burakkemalkara/MetuInstrumentProject/Presentation/metu_instruments.pptx

## METU INSTRUMENT

DC/DC CONVERTER
WITH FORWARD TOPOLOGY

## WHY DO WE SELECT FORWARD TOPOLOGY?

ADVANTAGES:
- No air gap in transformer design
- Less current ripple than flyback since filtered output
- Lower current ripple due to larger magnetizing inductance

## WHY DO WE SELECT FORWARD TOPOLOGY?

DISADVANTAGES:
- More components higher cost
- In DCM gain changes too much
- Higher voltage on mosfet and diodes

## TOPOLOGY SELECTİON

- We decide to use Reset winding to increase efficiency
- Select 100kHz,
1. Decrease ripple voltage
2. Increase response of controller

## Transformer Selection

- R material has lower core loss than P material
- E45959 is 2250 W core for 100kHz

## Transformer Design

- Reset windings and Primary windings same, Max D=50%
- Turn ratio is 2 satisfy output gain conditions.
- Minimum turn ratio should be 3 to ensure no Saturation.

## Transformer Design

- Select wire according to max current;
- At min. input voltage,input current is 2A
- Output current is 1A.
- Since system not ideal, efficiency is not 100%,

## Transformer Design

- Core Loss,
- Copper Loss,

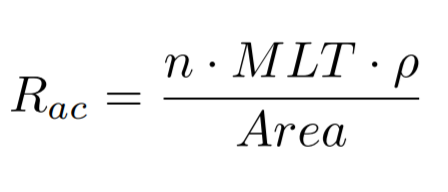
[picture p10: figure]

## Transformer Design

- Window area=550 m^2.
- K_fill=0.3 litz wire.
- Calculations show max N is 70.
- Most efficient N=8.


## Transformer Parameters

## MOSFET Consideration

- Voltage drop is multiple of input voltage, since Reset Winding
- Vds>100V
- Aimed efficiency is 85%, so max input current,

## Mosfet Consideration

IRF 740 N available component at lab.
R_on=0.55 ohm
t_on and t_off is much smaller than Ts

## HeatSink

- TO-220 Package
- ATS-PCB1020
- Rc=6.4

## Component Selection

Output Inductor Consideration
This result is also verified by simulation, but in simulation higher value inductance are needed because of non-idealities.

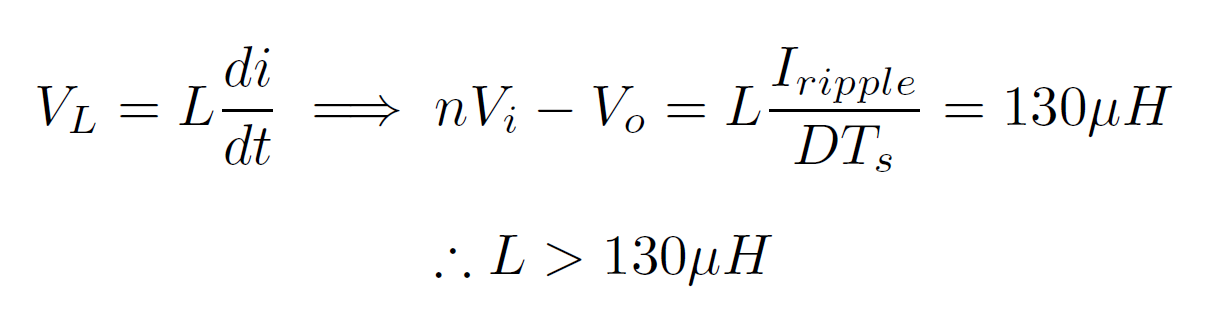
[picture p11: figure]
nesne, saat içeren bir resim Açıklama otomatik olarak oluşturuldu

## Output Inductor Selection

CG3885-ALB 470µH inductor is chosen according to simulation results.
It has 10 A max current and 8 mΩ max DC resistance.

## Output Capacitor Selection

This result is also verified by simulation, but in simulation higher value capacitor are needed because of non-idealities.

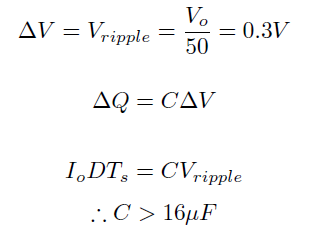
[picture p12: figure]

## Output Capacitor Selection

860080675012 150 µF capacitor is selected.
It has 0.05 Ω ESR value and 50 V DC voltage rating

## Diode Selection

Nearly 100 V has observed on diodes in simulation

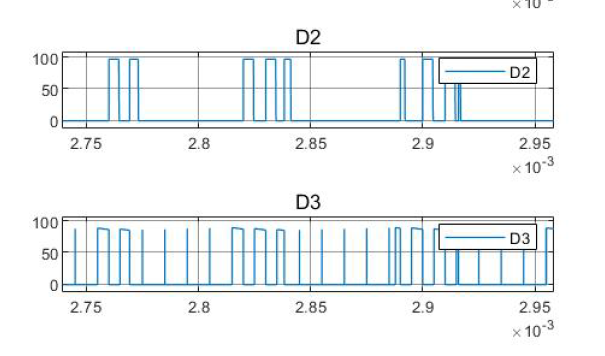
[picture p13: figure]

## Diode Selection

For safety, 200 V 10 A diodes are chosen (DPG10I200PM)
It has 0.98 VF and 0.1 µC recovery charge
35 ns recovery time
-> Vf*If = 0.98V *3.2A = 3.13W conduction loss
QR*VR*fs = 2W switching loss

## Aimed Bonuses

Analog Controller IC: UC3844

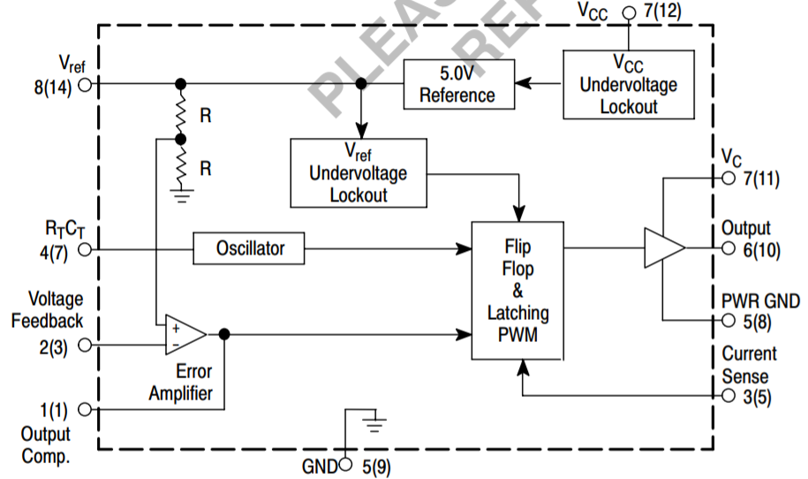
[picture p14: figure]

## UC3844

- Current Mode Controller
- Voltage Feedback
- Soft Start

## Efficiency Bonus

- As simulated at Matlab efficiency is %85.

## Current Mode Control

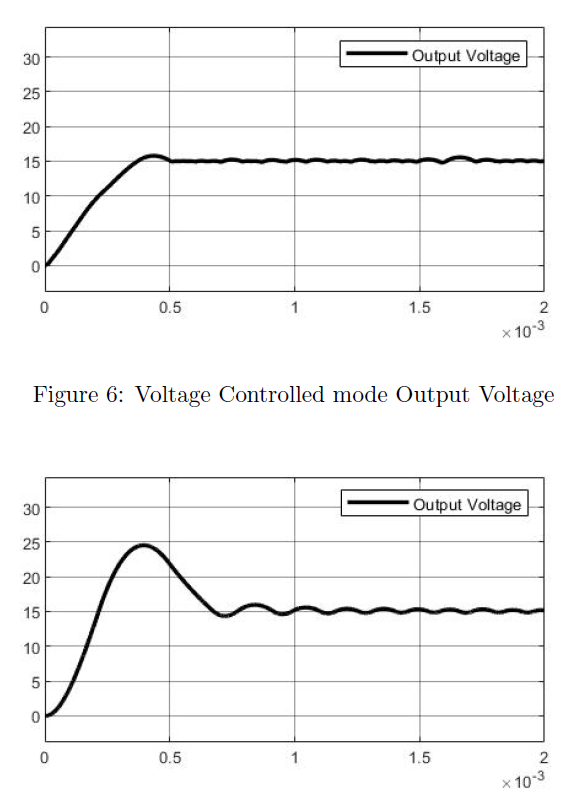
[picture p15: figure]

Current control Mode control decrease
oscillations and output reach steady
state faster.

## Slide 24

- Voltage Control Block

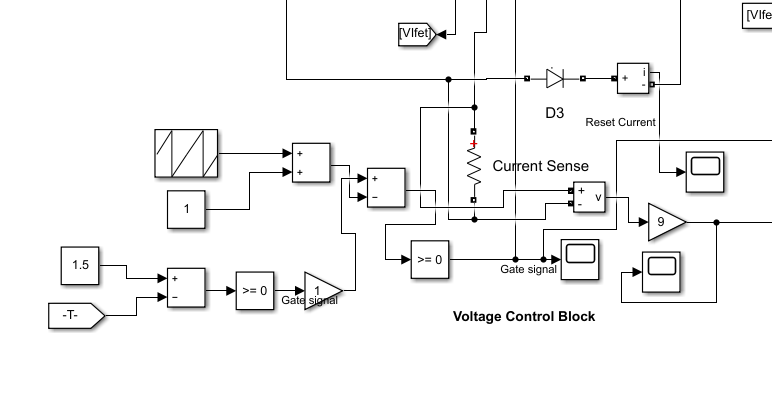
[picture p16: figure]

## Slide 25

- Current Control Block

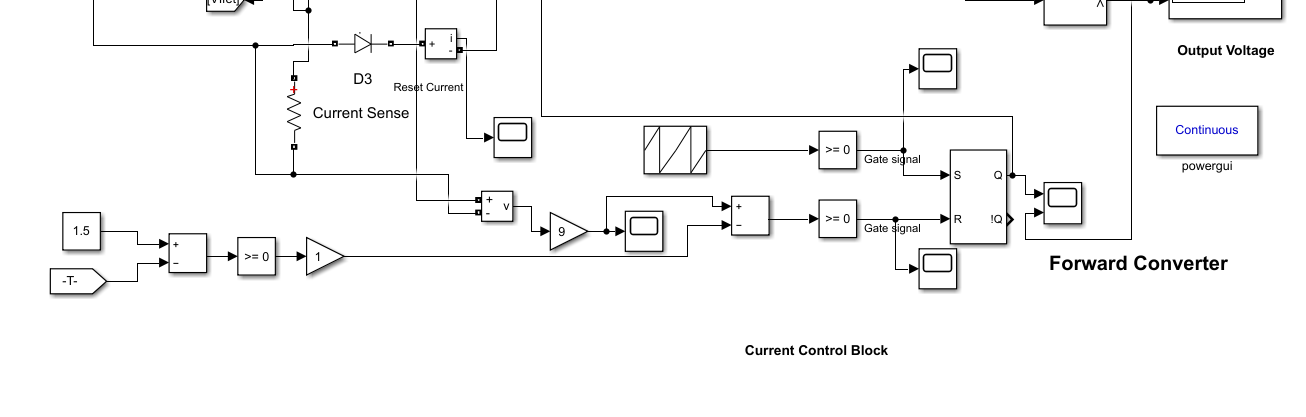
[picture p17: figure]

## PCB

We are planning to implement our nal circuitry on Printed Circuit Board (PCB). Because PCB has some advantages over stripboard. It is more professional than stripboard and it is less noisy. Also, after drawing proper PCB layout it is easy to implement.

## Soft Starting

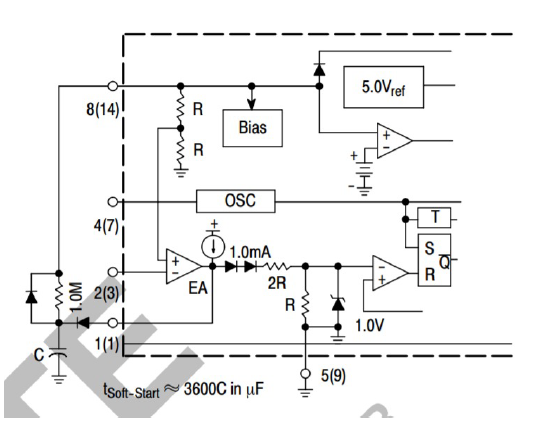
[picture p18: figure]

Soft Starting Ciruit of UC3844

## Isolation

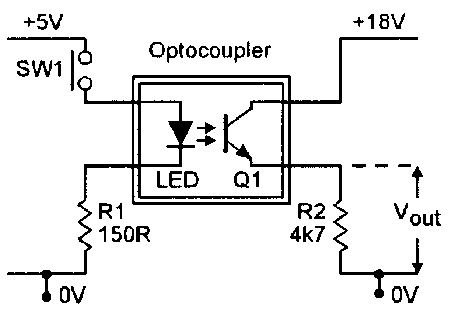
[picture p19: figure]

TLP250 Optocoupler

## Slide 29

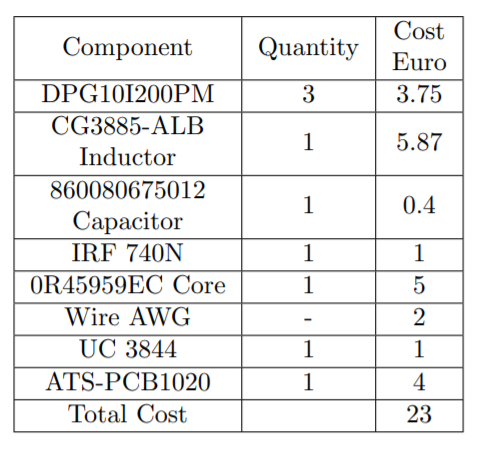
[picture p20: figure]
