burakkemalkara/MetuInstrumentProject/final_report/report.pdf

# DC/DC Voltage Regulator

# Complete Design Report

# Cemil Urg¨up ¨

# Burak Kemal Kara

# A report presented for the sake of Humanity and Science

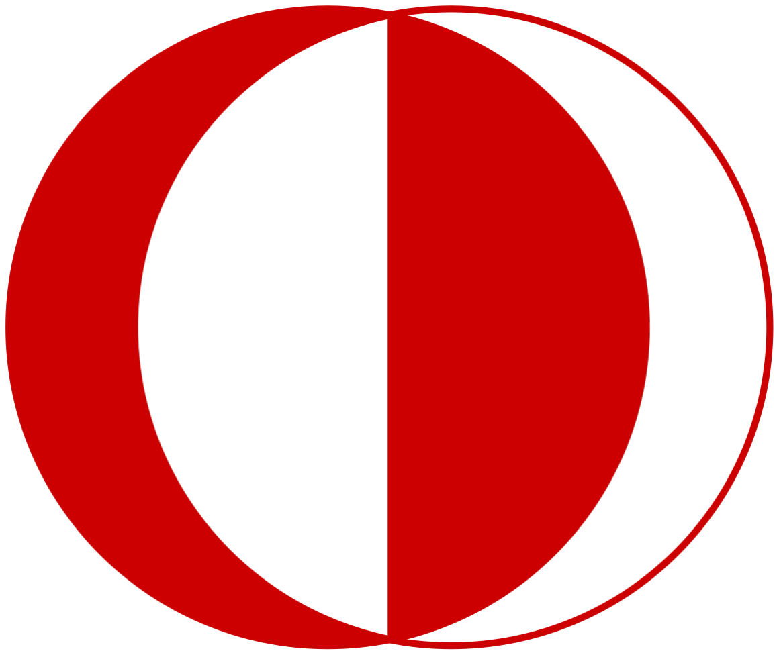
[picture p21: figure]

## Electrical & Electronics Engineering MIDDLE EAST TECHNICAL UNIVERSITY TURKEY

24.05.2020

## Contents

1 Introduction | 2
2 Forward Converter topology | 2
3 Design Equations | 3
4 Input to Output TF | 8
5 Compensator Parameters | 11
6 Current Mode Controller | 13
7 Efficiency and Thermal Analysis | 14
8 Complete simulation in Simulink | 15
9 PCB Design | 15
10 Conclusion | 18

## 1 Introduction

Switch mode power supplies are commonly used to DC/DC converter applications. Beside of voltage control, it provides galvanic isolations. In this project we used Forward Converter topology which is good choice when output need high current and power range is below 200W. In addition, UC3844 IC is examined and simulated in order to obtain constant output voltage with current control. This document aims to discuss component selections,cost and power estimation according to teoric and computational simulation results.

## 2 Forward Converter topology

Forward converter topology is derived from buck converter, at each cycle input transfer power to load side. To avoid saturation at core we choose to use reset windigs.Details are shown Figure 1.


Figure 1: Diagram,schematic and basic waveforms for Forward converter with reset winding cited [5]

In this project, we had different design options as can be seen from Figure 2.


Figure 2: Different Design alternatives of the project

From these alternatives, Forward #1 option is selected. Although, Forward Converter has more components and it is more complex than Flyback Converter, it has some important advantages over Flyback converter such as:

- It has better transformer utilization. It transfers its energy instantly across the transformer and it does not need energy storage element in transformer. For that reason, transformer can be more ideal with higher magnetizing inductance and no air gap

- Output inductor and freewheeling diode ensure continuous output current and it causes less ripple at the output. Furthermore, since main energy storage element is inductor, output capacitor can be smaller than flyback.
- It has less voltage and current stresses on switching components because of larger magnetizing inductance.

Disadvantages of Forward Converter compared to Flyback:

- It is more expensive than flyback because of extra freewheeling diode and output inductor.
- It has minimum load requirements because gain changes a lot in DCM operations

## 3 Design Equations

The following specifications are design equtions for Forward Converter Design.

Minimum Input Voltage (V) | 24
Maximum Input Voltage (V) | 48
Output Voltage (V) | 15
Output Power (W) | 48
Output Volt. Peak-to-Peak Ripple (%) | 2
Switching Frequency (fs) | 100 kHz

Table 1: Design specifications

### 3.1 Transformer Considerations

First of all we should calculate turn ratio of transformer. For the sake of simplicity reset winding and primary winding ratio is same.
n1 = n3 | (1)

This equation limit max duty ratio to 50%, since core cant demagnetize faster than magnetizing time. Primary and secondary winding ratio can found when critical points are considered. When Input decreased minimum, Duty cycle reached max. ratio.At this point this converter should supply desired Vo.

Vo < vi

n3
n1

D =⇒

n3
n1

>

Vo
Vi
- D
= 1.33 =⇒ 2 | (2)

When Vo = 15V as specifications, extra voltage drop on D2 around 1V. Vo,max = 16V .
Minimum voltage is 24 V.
Maximum D is 50%.
At this point we choose R type material ferrite core (Code:0R45959EC). We selected since,R type core loss is less than P type core. According to this core turning factor can found from Lenz Rule,

V = n1

dφ
dt =⇒ Vi,max =

n1 · Bsat · Ae
Dmax · Ts

(3)

∴ n1 > 2.18

Vi,max=48 V
Dmax=0.5
Bsat=0.3
Ae = 368mm²
taken from datasheet [3].

This is minimum turning ratio to avoid core saturation. To calculate max turn number we should calculate wire type to know wire size. At the worst scenario we have Vin,min = 24V . For primary winding,

Iprimary =

Po

Vin,min

= 2A | (4)

For secondary winding,

Isecondary =

Iprimary
n
= 1A | (5)

Since this currents ratings are for ideal case, it is safer to choose higher rating wires.From AWG chart,for primary and reset windings can use AWG #16, Secondary AWG #18. Selection criteria is max current. Their properties are shown at table 2.

AWG | Area mmˆ2 | Max. Current Amperes
AWG#16 | 1.31 | 3.7
AWG#18 | 0.823 | 2.3

Table 2: Wire properties

Core window area is calculated from datasheet.Also geometry parameters are taken from datasheet [3].

Aw = (E − F) · D = 510mm²
(6)

Since area of wires are known max turn can be calculate by,

Nmax =

kf ill · Aw

Apri + n · Asec + Areset

= 71.73 | (7)

Note that fill factor is 0.3 for litz wire.Increasıng turn is good because flux density decreasing and core loss decreasing according to Steinmetz equation, but increased turn also increase resistance of wire and copper loss increased. Core loss equation,

Pf e = Kf e(Bpeak)

βAclm | (8)

Pf e at 100kHz,100mT given 85mW/cm³
Pf e at 100kHz,200mT given 550mW/cm³
By using these values steinmetz parameters calculated as,

∴ β = 2.7 , Kf e = 42

Core loss is simply I

2Rac but wires new resistance should be calcualted by skin effect.Since skin depth decrease wire area new resistance calculated by,

Rac =

n · MLT · ρ
Area | (9)

To find optimum turn number loss calculated at matlab script which provided at github repo.


Figure 3: According to number of turn Total loss calculated

It is better to select turn ratio 8 which Total loss is 1 Watt. At this number Rpri = Rreset = 0.05kΩ, Rsec = 0.06kΩ.
By using AL number windings inductance found and,

Xm = k ·

p
X1 · (X2 + X3) = 1060µH | (10)

Since reset and secondary windings direction same they summed. Also from Steinmetz eqn. Rm can found.Where applied voltage is 48 V.

Pf e = 0.1375W att =⇒ Rm =

V

2
Pf e
= 16.7kΩ | (11)

### 3.2 MOSFET Considerations

Since when switch is off, reset windig decharge core, beside of input voltage additional voltage seen on mosfet.

Vs = Vi +

n1
n2
- Vi = 96V | (12)

For the worst case, selected Vi = 48V . To be stay at the safe side lets make it 150V.

Ii =

Pi
Vi
= 2.22A | (13)

To be safe side minimum current of mosfet should be 5 A. We selected to use IRFB4127PbF [2], its voltage is 200V and Ron = 20mΩ.
According to datasheet turn on and turn off time is totally 120ns.This much smaller than switching toff and toff.

Pcond = I

2
rms · Ron = 0.27W | (14)

Pswitching =

1
2
- Vof f Irms(tr + tf )fs = 1.55W | (15)

Lets use heatsink,Model No. :529802B02500G. Its Rca=3.7C/W. MOSFET Rth is 0.52.Assume enviro-ment temperature is 30C. Thus,

Tj = Cnormal + Ptotal · (RJC + RCS + RJA) = 38.37Celcius. | (16)

### 3.3 Output Inductor Considerations

Since %2 voltage ripple, current change is Iripple = 0.02 ·

Po
Vo

= 0.064AAssume we apply 48 V input, and capacitor is big enough to constat output,

VL = L

di
dt =⇒ nVi − Vo = L

Iripple
DTs
= 130µH | (17)

∴ L > 130µH

We considered ripple voltage limit in our simulations and we chose 470 µH inductor according to our simulations. In addition, previous 10 A current rating selection must be valid for inductor. Therefore, we picked an inductor with 10 A maximum DC current and 470 µH inductance which is “AGP4233-474ME” inductor from Coilcraft. It has also 11.5 m maximum DC resistance and we used that value in our simulations. Since inductors has nonideal series resistance values, there are power losses of these resistance values also. AGP4233-474ME inductor has 11.5 m resistance and it has 3.2 A current. Therefore, power losses on inductor can be calculated as follows:

Pinductor = I

2
- R = 3.2

2

- 11.5 · 10⁻³ = 0.1W | (18)

### 3.4 Capacitor Considerations

When Vin = 48V , D=0.156,

∆V = Vripple =

Vo
50
= 0.3V | (19)
∆Q = C∆V | (20)
IoDTs = CVripple | (21)

∴ C > 16µF

Because of ripple voltage limit, we chose 150 µF capacitor. In addition, we select voltage rating of capacitor as 50 V because of safety limit and possibility of voltage oscillation in case of soft start does not working. Therefore, we picked “860080675012” capacitor from W¨urth Elektronik [4].From datasheet impedance at 100kHz is 0.068Ω.
impedance = ESR +

1
jwC =⇒ ESR = 0.05Ω | (22)

### 3.5 Diode Considerations

As can be seen from Figures 4, there are 100 Volts when diodes are OFF and there are 3.2 A current when they are ON. Therefore, because of safety margin and high current possibility at the starting we chose 200 V and 10 A ratings for diodes. Hence, we picked “DPG10I200PM” [1] fast recovery diodes. For diodes another important parameter is reverse recovery time and this diode has 35 ns which is enough for 100 kHz frequency applications.


Figure 4: Diodes

Output diodes has 0.98 V voltage drop and at steady state their current will be 3,2 A. When one diode is ON the other diode is OFF at the output. Therefore, we can calculate conduction losses by simply multiply voltage drop and forward current.

Pconduction = Vf If = 0.98V · 32A = 3.13W | (23)

For calculating switching losses of diodes, reverse recovery charge, blocking voltage and switching frequency is needed. From Figure 5, we can estimate our reverse recovery charge as 0.1 µC. Blocking voltage is 100 V from simulations and switching frequency is 100 kHz.


Figure 5: Reverse recovery charge values of DPG10I200PM

From these values, switching losses of two diodes can be calculated as follows:

Pswitching = QRVRfs = 2 · 0.1 · 10⁻6 · 100V · 100kHz = 2W | (24)

We used same heatsink that we use at mosfet

Tj = Cnormal + Ptotal · (RJC + RCS + RJA) = 73Celcius. | (25)

## 4 Input to Output TF

To derive TF, first I will find small signal circuit equivalent. Forward converter can be treated as a buck converter with Vin = n · Vin where n is transformer ratio.

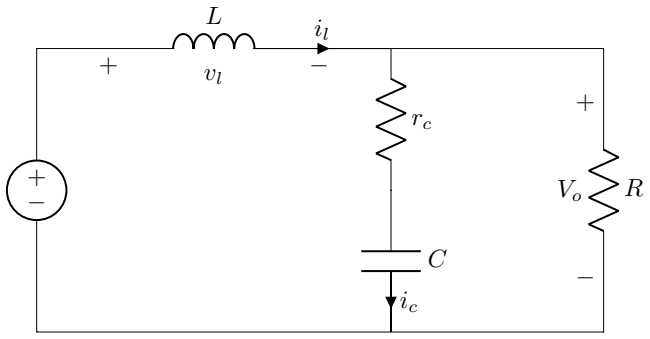
[picture p22: figure]

Figure 6: Simplified Forward Converter when switch is on

KVL at the outer path,

−nVin + L

di
dt + ioR = 0 | (26)

Since,
io = il − ic | (27)

L

di
dt = nVin − Ril + Ric | (28)

Find ic by KVL on inductor and capacitor

−nVin + L

di
dt + icrc + Vc = 0 | (29)

ic =

nVin − L

di
dt − Vc
rc

(30)

Insert ic into equation 3, ˆil =

di
dt =

nVin
L

−

rcR
(rc + R)L

R
(rc + R)L
Vc | (31)

We know that R >> rc so we can simplify equation as,

ˆil =

nVin
L

−

rc
L

il −

1
L
vc | (32)

Start derive Vc by KCL at output node,

ic = il −

Vo
R

(33)

Since,
vo = vc + rcic | (34)

ic =

R
R + rc

il −

1
R + rc
vl | (35)

Since,

vˆc =

ic
C

(36)

vˆc =

R
C(R + rc)

il −

1
C(R + rc)
vl | (37)

We know that R >> rc so we can simplify equation as,

Vˆ
c =

1
C

il −

1
RC vl | (38)

According to state space equations,

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
Vin | (39)

For switch off position A matrix hasn’t changed.But B matrix multiplied with duty ratio so,

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
Vin | (40)

Find vo as state space variables,
vo = vc + rcic | (41)

Since,
ic = il −

v − o
R

(42)

vo = vc + rcil −

vorc
R

(43)

vo =

rcR
rc + R

il +

R
(rc + R)
vc | (44)

Since rc << 1,
vo = rcil + vc | (45)

C =

rc
1
(46)

vo(s)
d(s)

= C

T
[SI − A]
−1BVin | (47)

After a lengthy evaluation control to output TF is,

Gvd =

veo
de
vei=0

=

nVin

LC "
srcC + 1
s

2 + s(

rc
L +

1

RC ) + 1

LC #
(48)

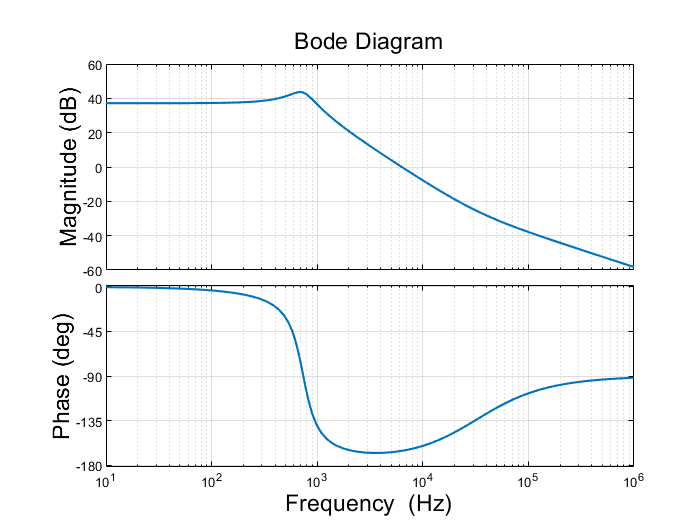
[picture p23: figure]

Figure 7: Bode plot of control to output TF

According to [erickson] Crossover Frequency is defined as the frequency where the magnitude of loop gain is unity.Limit for fc is pole frequency since we want to operate unity gain at fc.For power application switching frequency selected as one in ten or five.For this application I select as,

fc =

fsw
5
= 20kHz | (49)

Since fESR = 32kHz and fLC = f734Hz,

fLC < fc < fESR < fsw/2 | (50)

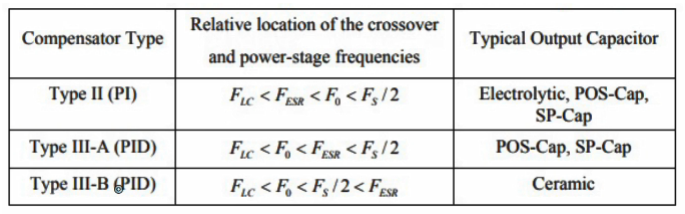
[picture p24: figure]

Figure 8: Compensator Selection table

According to table 8 I select Type 3-A compensator for this application.Type 3 compensator supplies phase boost for this converter to operate stable region.

## 5 Compensator Parameters

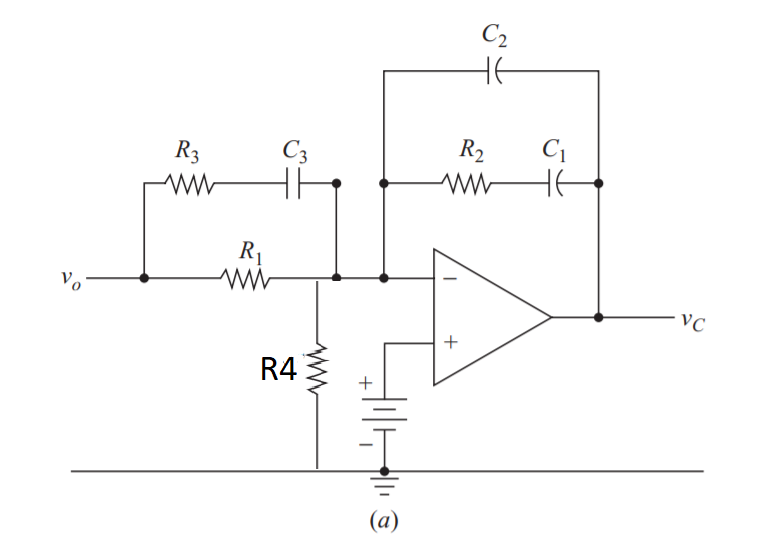
[picture p25: figure]

Figure 9: Type 3 Compensator

This compensator is referred from [erickson] book except one extension.R4 added to adjust input voltage range. When fc = 20kHz, from bode plot phase angle is -146 and gain is -20 db. Vref = 3V , which corresponds -9.5db.
|G(jwo)| = 29.5dB = 29.5Gain | (51)
θcomp = θphase−margin − θconverter = 45 − (−146) = 191 | (52)

K = tan191 + 90
2

2
= 7.75 | (53)

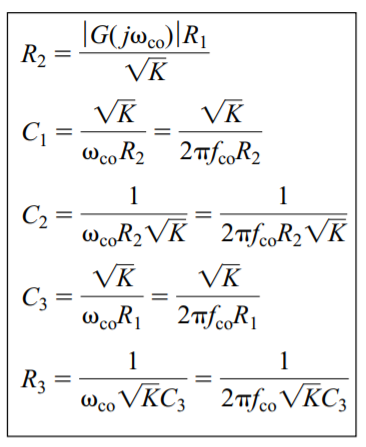
[picture p26: figure]

Figure 10: Type 3 Compensator equations

To start lets choose R1 = 1kΩ, Afterwards by using formulas at figure 5, other parameters found as,

R2 = 10.77kΩ , | C1 = 2nF , | C2 = 0.26nF , | C3 = 22nF , | R3 = 130Ω | (54)

It is suitable to measure output voltage with vo
3
| | ,

vref =

| vo
| 3 R4 R4 + R1 | =⇒ R4 =

vrefR1

| | vo
3 − vref
| | | = 1.5kΩ | | (55)

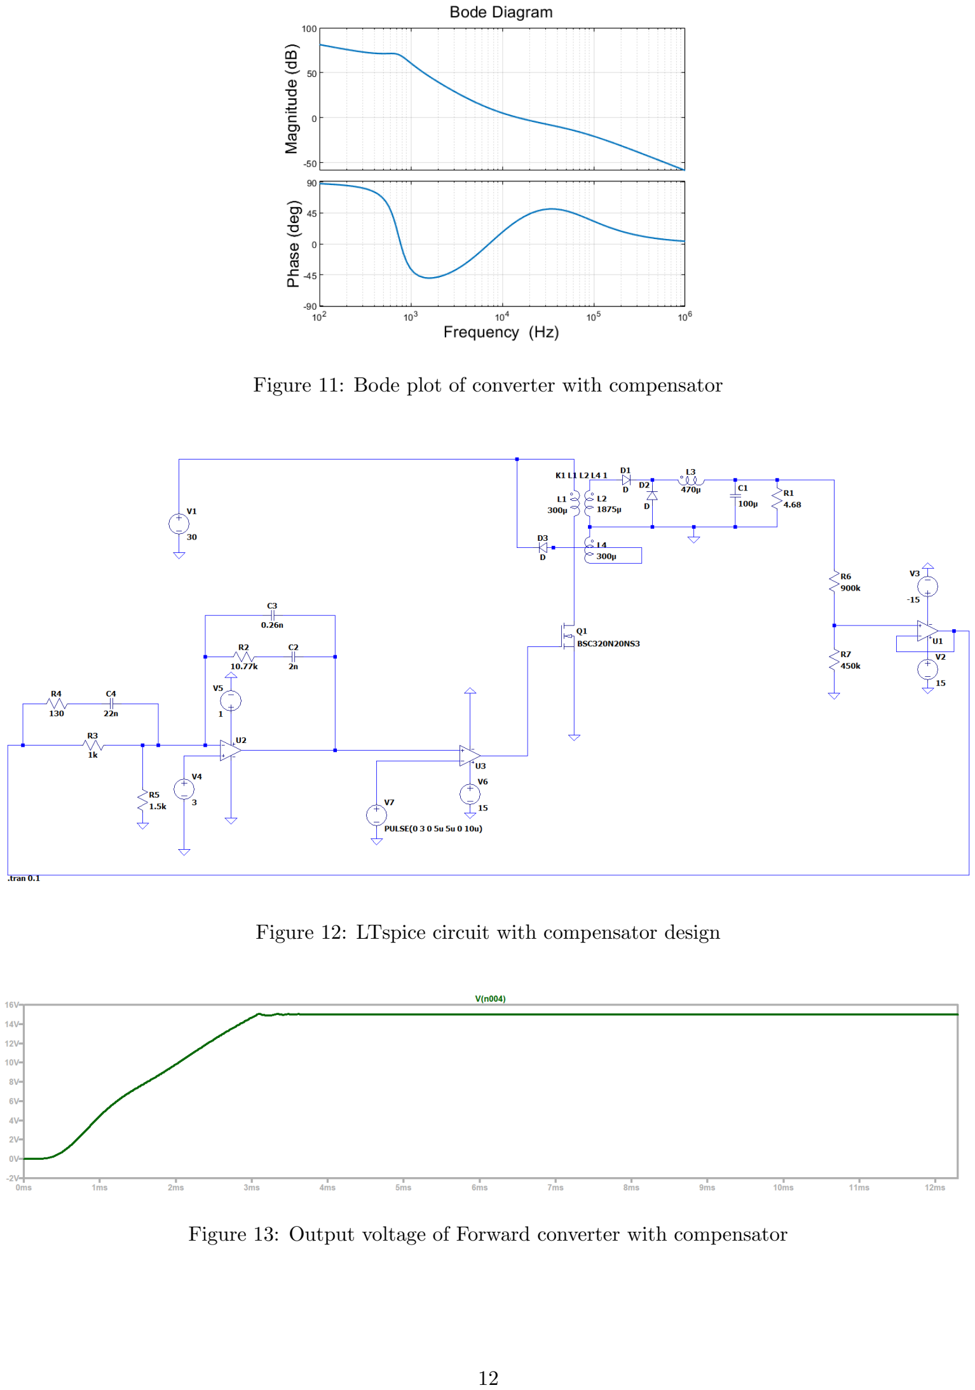
[picture p27: page 13]

Figure 11: Bode plot of converter with compensator

Figure 12: LTspice circuit with compensator design

Figure 13: Output voltage of Forward converter with compensator

## 6 Current Mode Controller

We select LT3758 current mode controller for this application.According to datasheet output voltage formula determined by feedback loop,

Vo = 1.6 ·

1 +

R2
R1
(56)

To have 15V resistor selected as,
R1 = 10kΩ , | R2 = 83.75kΩ | (57)

Sense pin is directly fed from to source of mosfet.Rsense used at the source of mosfet.According to datasheet

Rsense =

80mV

Il−peak

= 0.01Ω | (58)

Since operating frequency is 100kHz, according to datasheet 140kΩ fasten to RT pin. Also error amplifier used in this controller. At the datasheet they suggest to use typical application parametes at the datasheet.

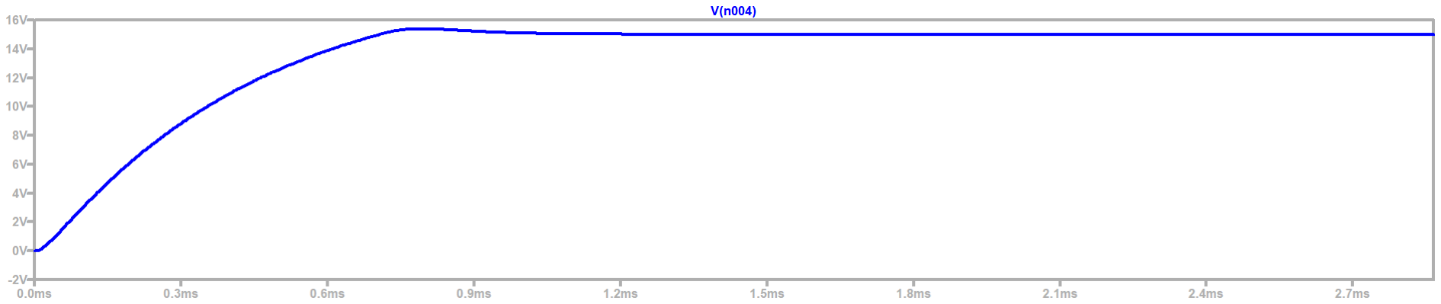
[picture p28: figure]

Figure 14: Output Voltage with current mode controller

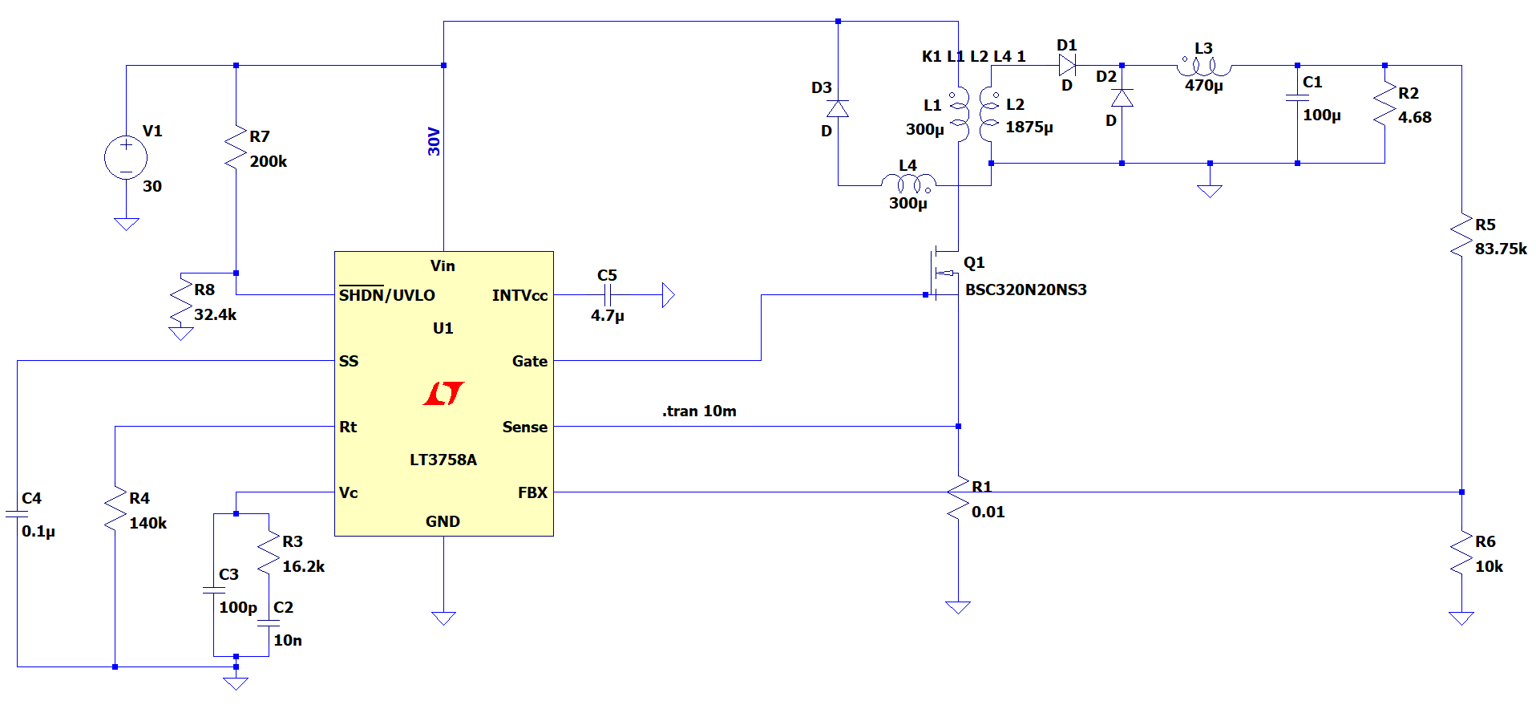
[picture p29: figure]

Figure 15: Circuit with current mode controller

Current mode controller is advantageous when compare with voltage control compensator. It is important that settling time of current mode controller is 5 times better than voltage control.Also steady state ripple decreases.

## 7 Efficiency and Thermal Analysis

### 7.1 Thermal Circuit Simulation

Thermal analysis checked by calculations before. In this section we will prove that simulation tools also gives close result with calculations.

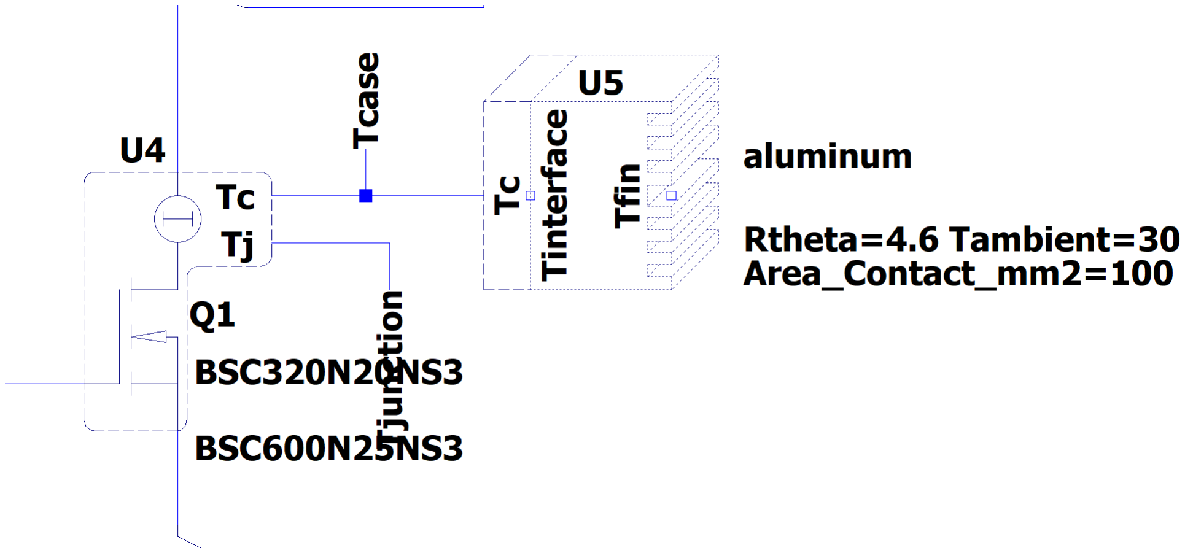
[picture p30: figure]

Figure 16: Thermal analysis simulation design

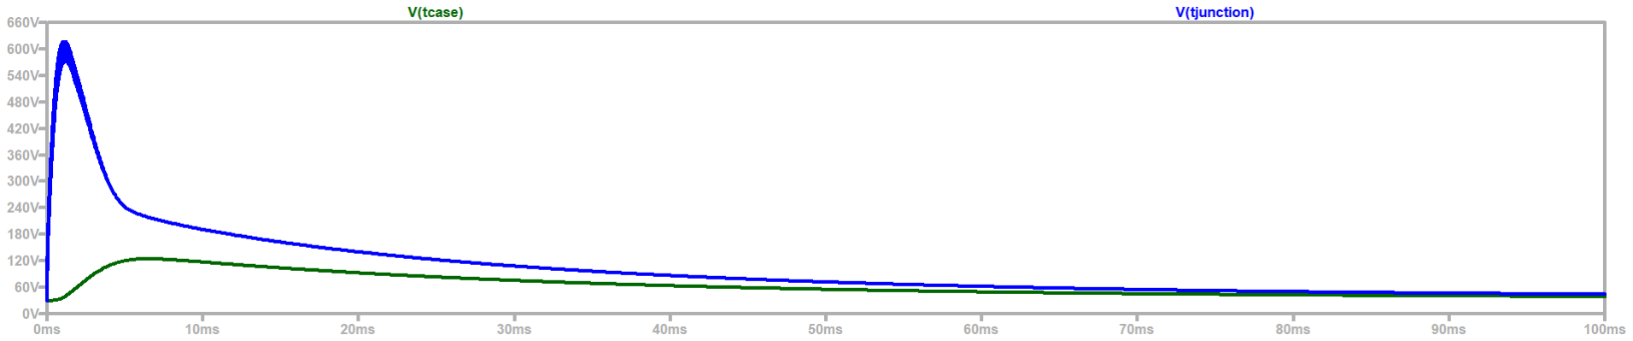
[picture p31: figure]

Figure 17: Junction and case temperatures when voltage compensator used

Figure 12 shows that FET temperature is saturated at 40 Celcius if ambient is 30 celcius.It is expected since we calculated analytically 38 Celcius.

### 7.2 Efficiency Simulation

As calculated analytically at design equations,

Ptotal,loss = Ptransformer + Pmosf et + 2 · Pdiode + Pinductor = 13.1W | (59)

eff =

Pout

Pout + Ploss

=

48W
48W + 13.1W
= %78 | (60)

We construct a forward converter at simulink environment with current mode controller.Efficiency of circuit with all nonidealities calculated at that simulink program. You can find it in github repository under simulation results.According to that simulation efficiency calculated as %73. This is close to our analytical result.

## 8 Complete simulation in Simulink

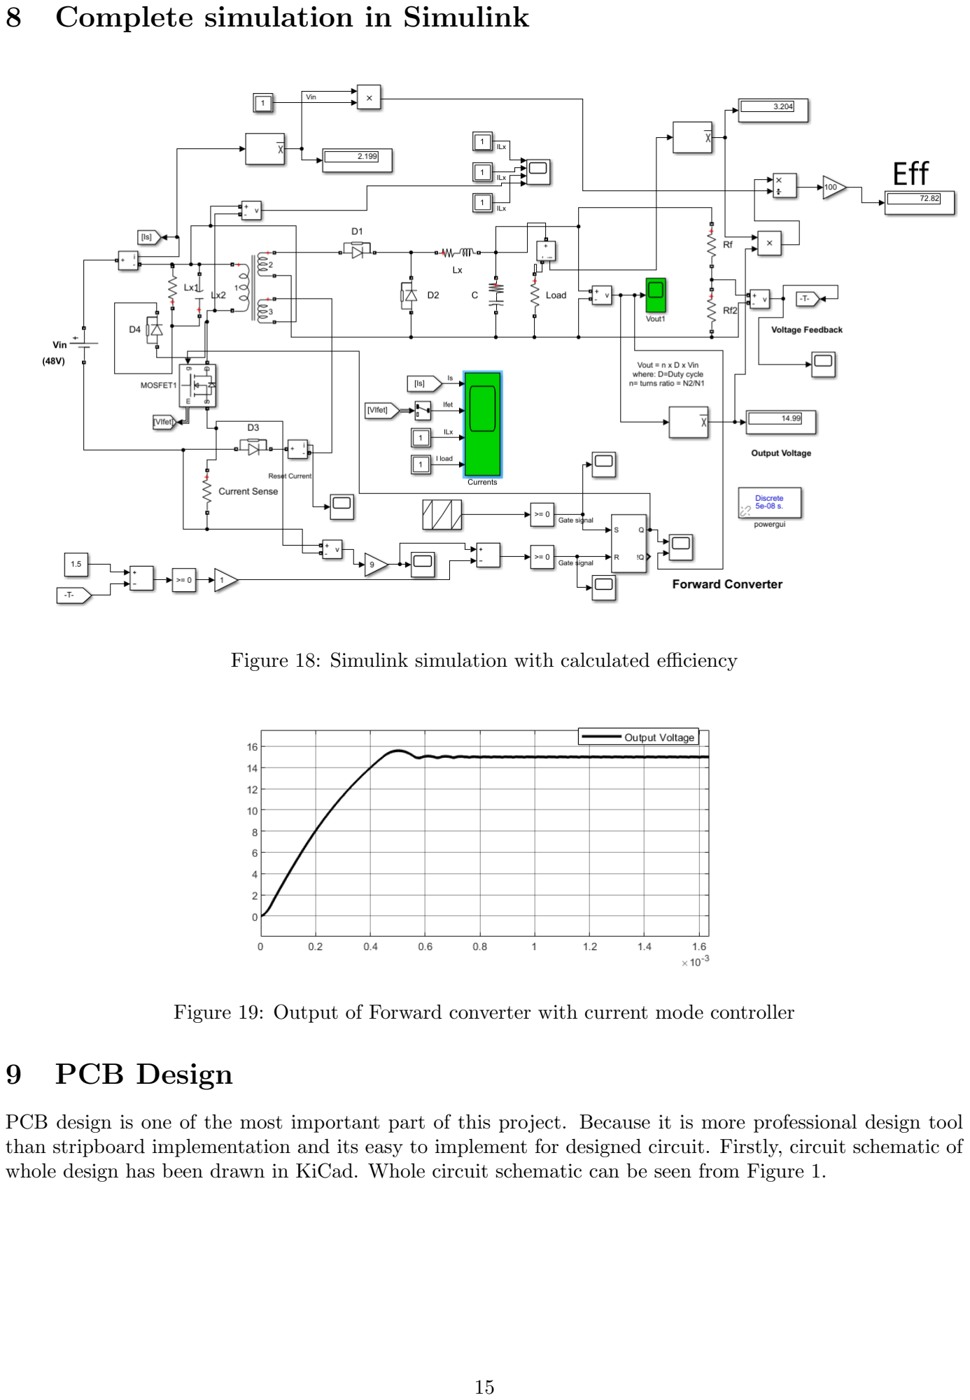
[picture p32: page 16]

Figure 18: Simulink simulation with calculated efficiency

Figure 19: Output of Forward converter with current mode controller

## 9 PCB Design

PCB design is one of the most important part of this project. Because it is more professional design tool than stripboard implementation and its easy to implement for designed circuit. Firstly, circuit schematic of whole design has been drawn in KiCad. Whole circuit schematic can be seen from Figure 1.

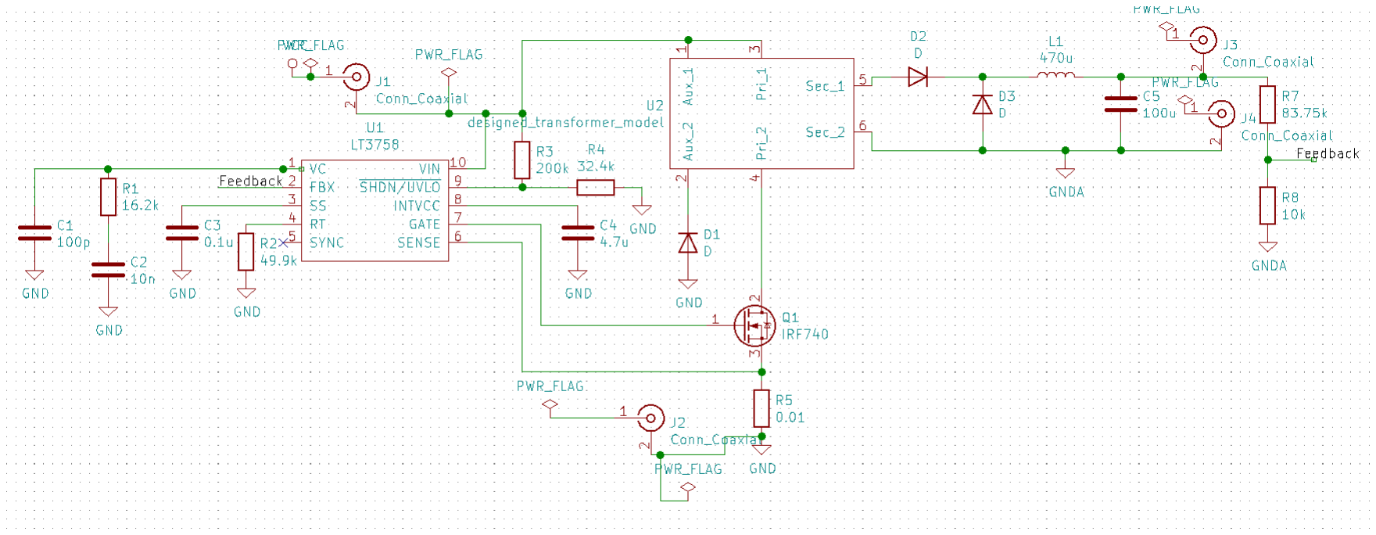
[picture p33: figure]

Figure 20: Circuit Schematic of Designed Circuit

In this schematic, controller, passive components, diodes, transistors and designed transformer is shown. Symbol of designed transformer is created by us because there is no proper symbol for a transformer with two main and one auxiliary winding. Transformer symbol has four input and two output. After completing circuit schematic, next task is arranging proper footprints to all components. Most of the components has their own footprints on KiCad, but some of them has no footprints of their own. Therefore, proper footprints have been drawn in KiCad, according to their packages. For example, footprints of transformer and output inductor has been drawn by us and matched their own schematic symbols. Then, next task is creating PCB layout. Connections between components were completed according to their footprints. Created PCB layout can be seen from Figure 2.

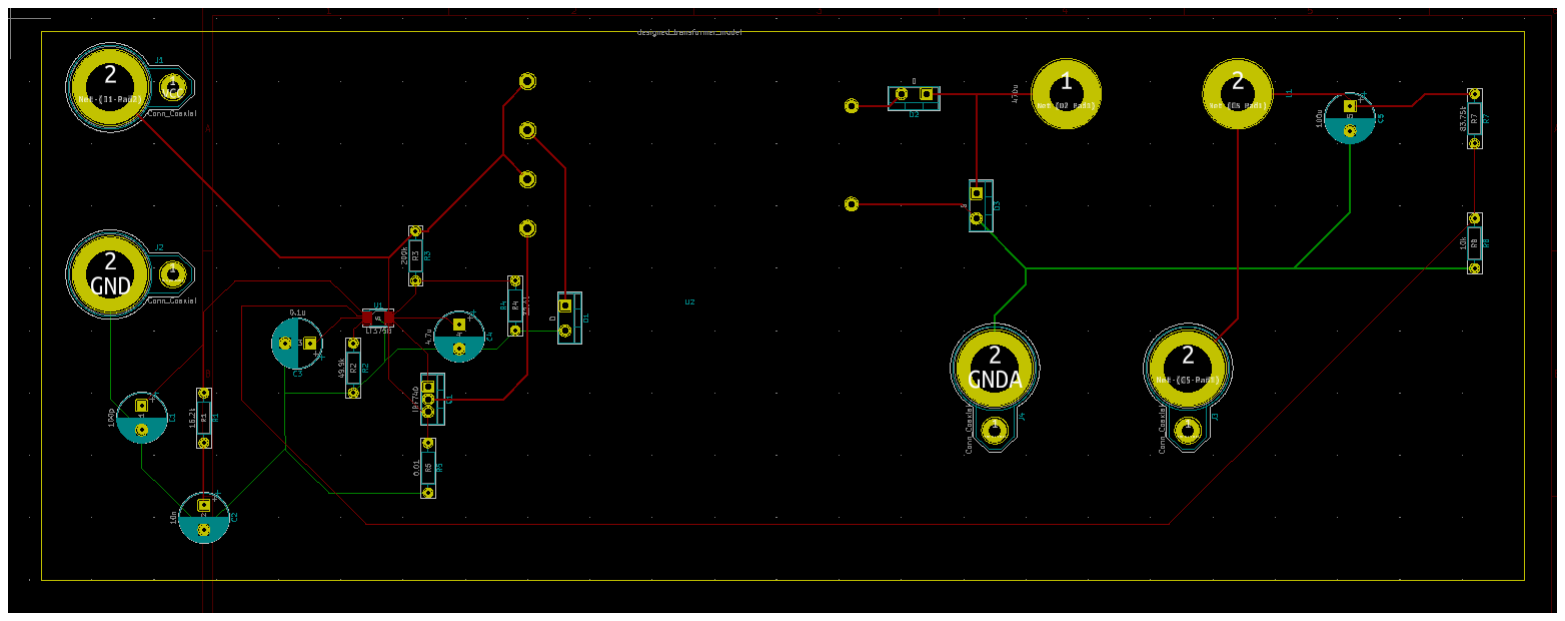
[picture p34: figure]

Figure 21: PCB Layout of the Circuit Schematic (without ground pads)

Widths of connections has been arranged according to current and power ratings of the components. There are use conventions for copper thicknesses and widths. We used below conventions to arrange widths of traces.

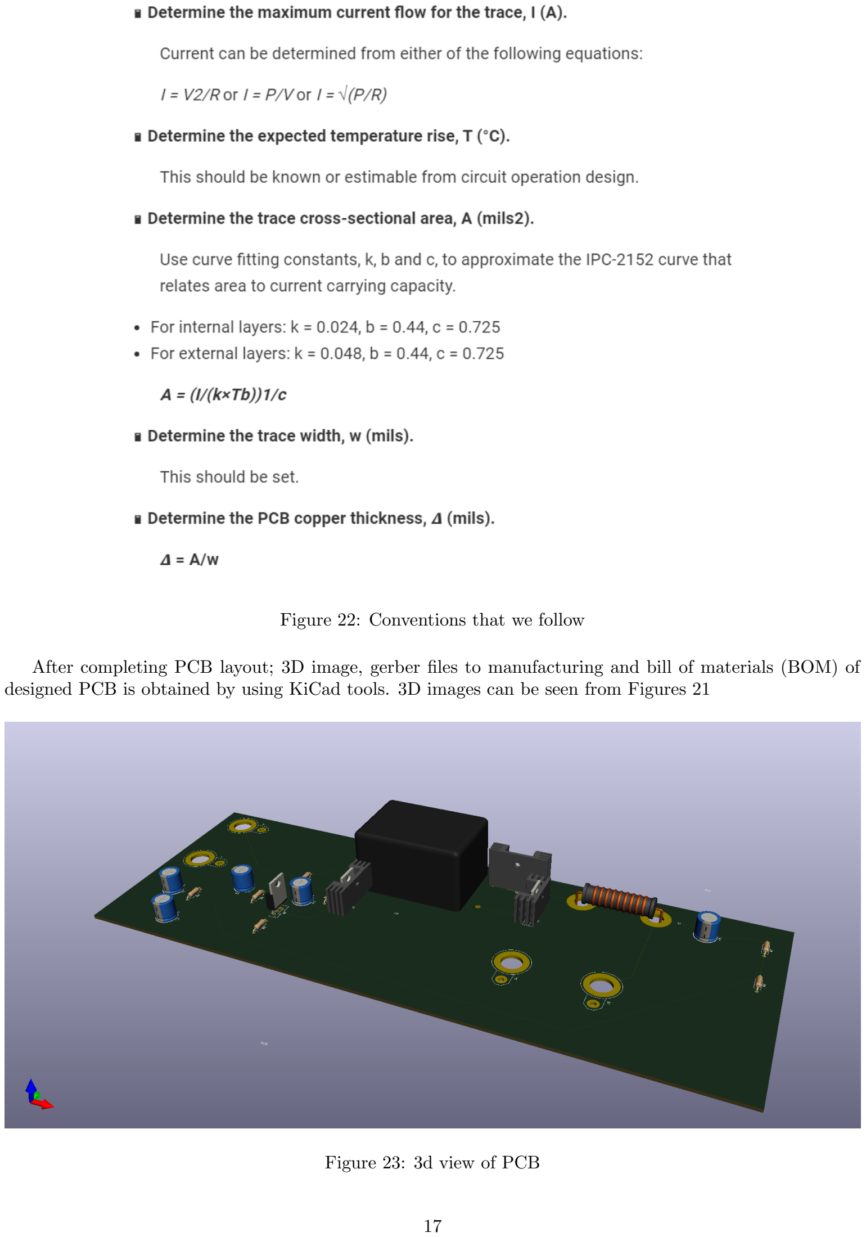
[picture p35: page 18]

Figure 22: Conventions that we follow

After completing PCB layout; 3D image, gerber files to manufacturing and bill of materials (BOM) of designed PCB is obtained by using KiCad tools. 3D images can be seen from Figures 21

Figure 23: 3d view of PCB

You can find BOM file at the github repository. We also order 1000 piceses of pcbs from pcbway.

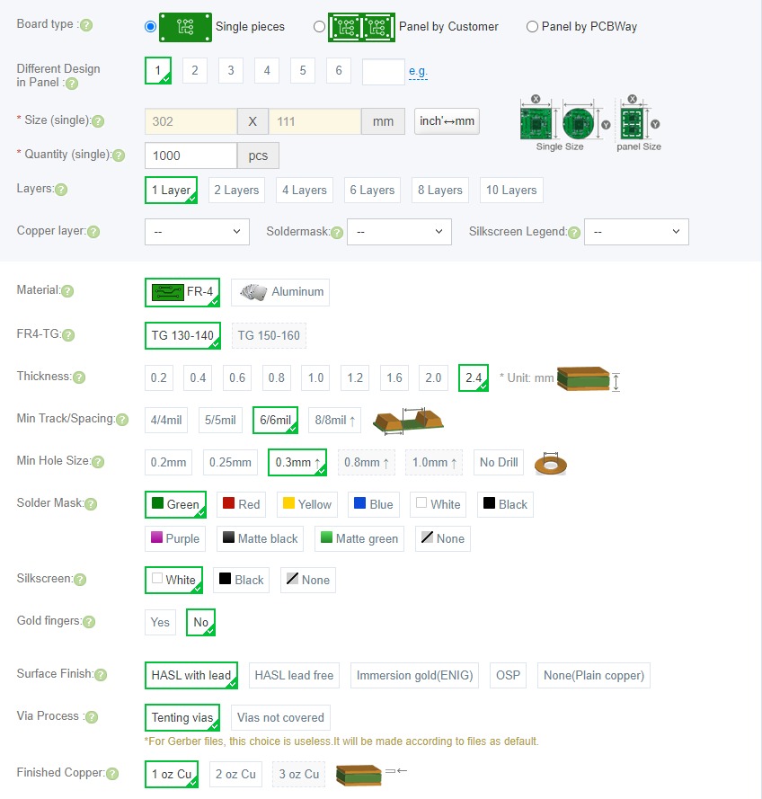
[picture p36: figure]

Figure 24: Ordered pcb properties

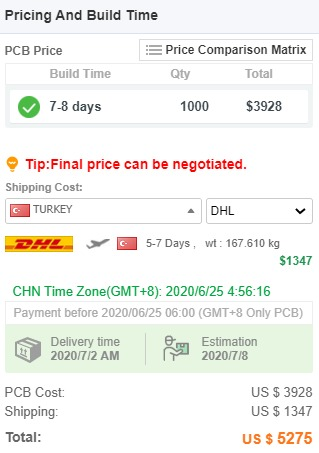
[picture p37: figure]

Figure 25: PcbWay bill

## 10 Conclusion

Forward converter designed with simulations, calcualtions and pcb designs. Observed how non-ideal char-acteristic affect converter. Investigate different control strategies on converter. Current mode control is advantageous on voltage control. We also analyzed that circuit temperature according to heatsink.

## References

[1] DPG diode. https://ixapps.ixys.com/Datasheet/DPG10I200PM.pdf.

[2] irfb4127pbf POWER MOSFET. (https://www.infineon.com/dgdl/irfb4127pbf.pdf?fileId=5546d462533600a401535615c2ef1e11) https://pdf.direnc.net/upload/irf740a-datasheet.pdf.
[3] 0R45959EC R Material Core. https://www.mag-inc.com/Media/Magnetics/Datasheets/0R45959EC. pdf. (https://www.mag-inc.com/Media/Magnetics/Datasheets/0R45959EC.pdf)
[4] Capacitor. https://www.mouser.com.tr/datasheet/2/445/860080675012-1726029.pdf.
[5] Forward Converter Topology. https://www.mouser.com/pdfdocs/2-10.pdf.
