burakkemalkara/MetuInstrumentProject/CC.PNG

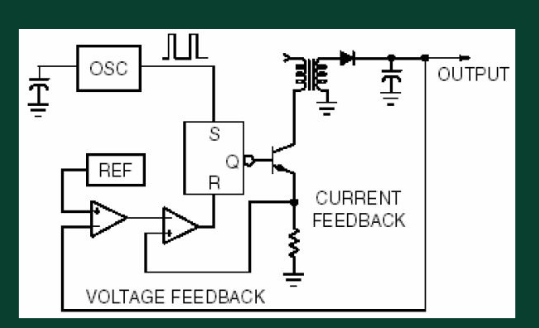
CC.PNG
