burakkemalkara/MetuInstrumentProject/final_report/bode_com.png

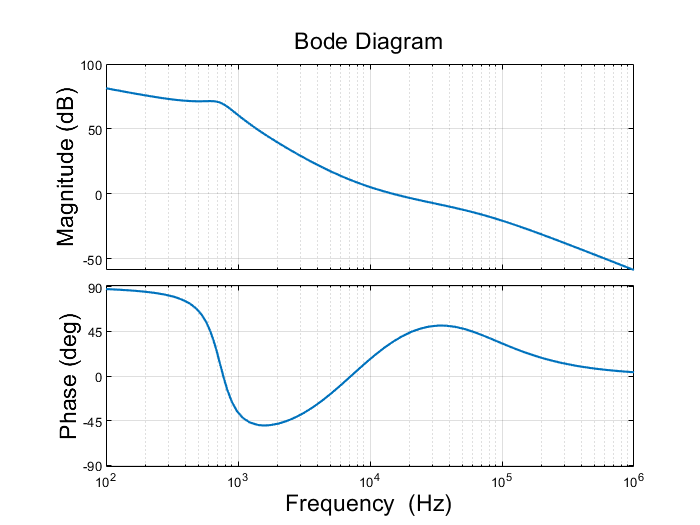
final_report/bode_com.png
