burakkemalkara/MetuInstrumentProject/final_report/compCircuit.png

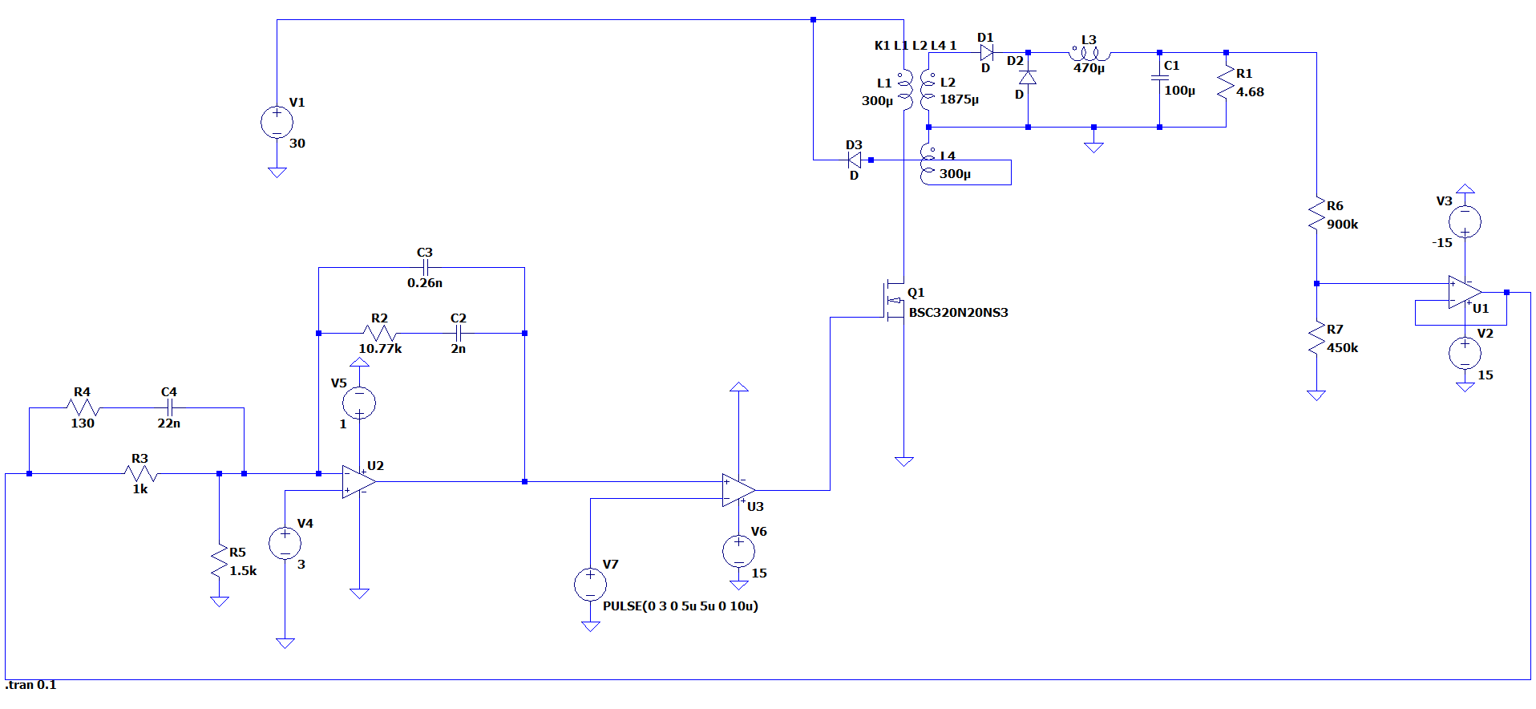
final_report/compCircuit.png
