burakkemalkara/MetuInstrumentProject/final_report/compout.png

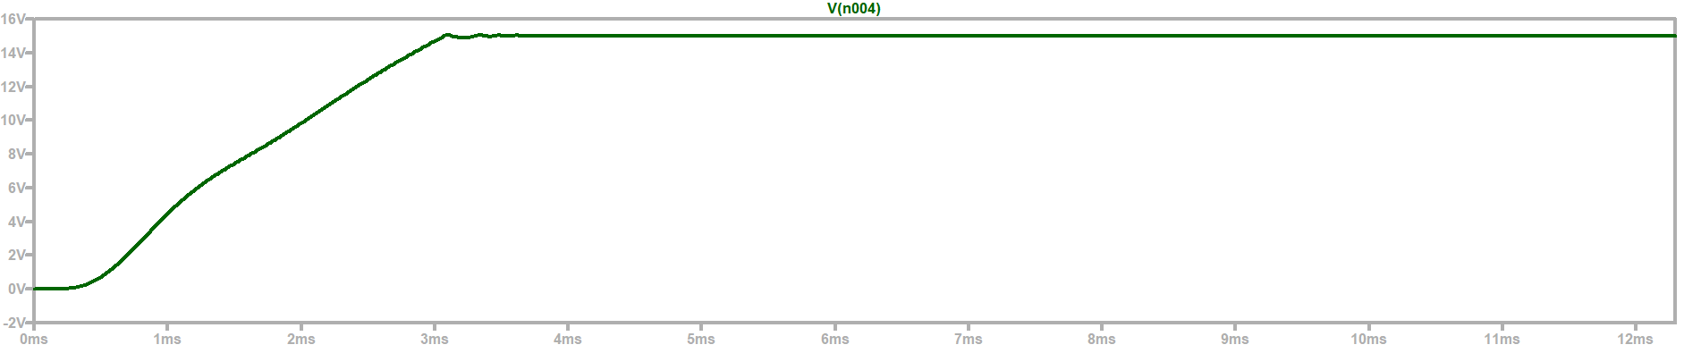
final_report/compout.png
