burakkemalkara/MetuInstrumentProject/final_report/currentControllerOutput.png

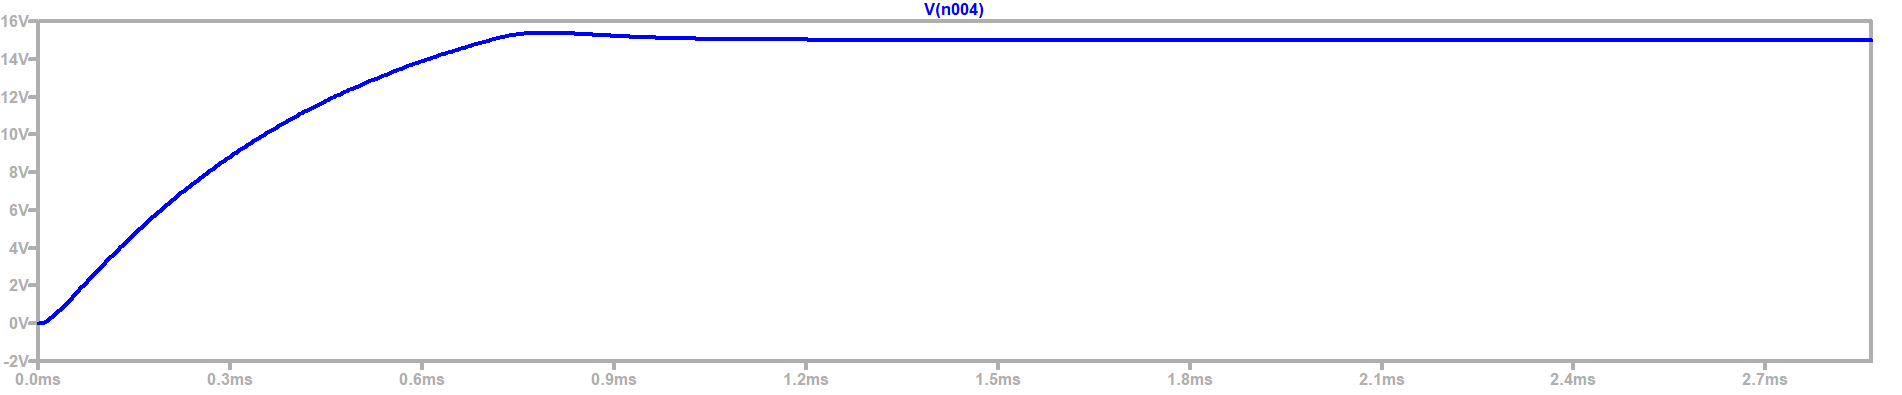
final_report/currentControllerOutput.png
