burakkemalkara/MetuInstrumentProject/final_report/simCur.png

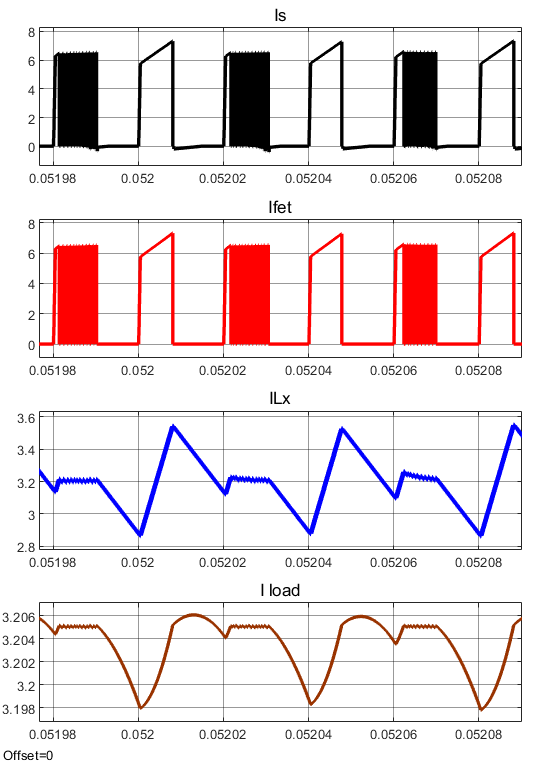
final_report/simCur.png
