burakkemalkara/MetuInstrumentProject/final_report/simOut.png

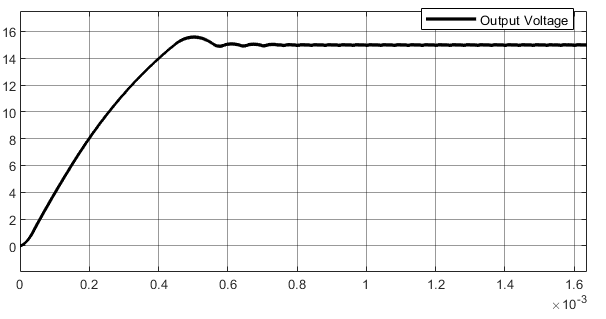
final_report/simOut.png
