burakkemalkara/MetuInstrumentProject/final_report/Sumilation.png

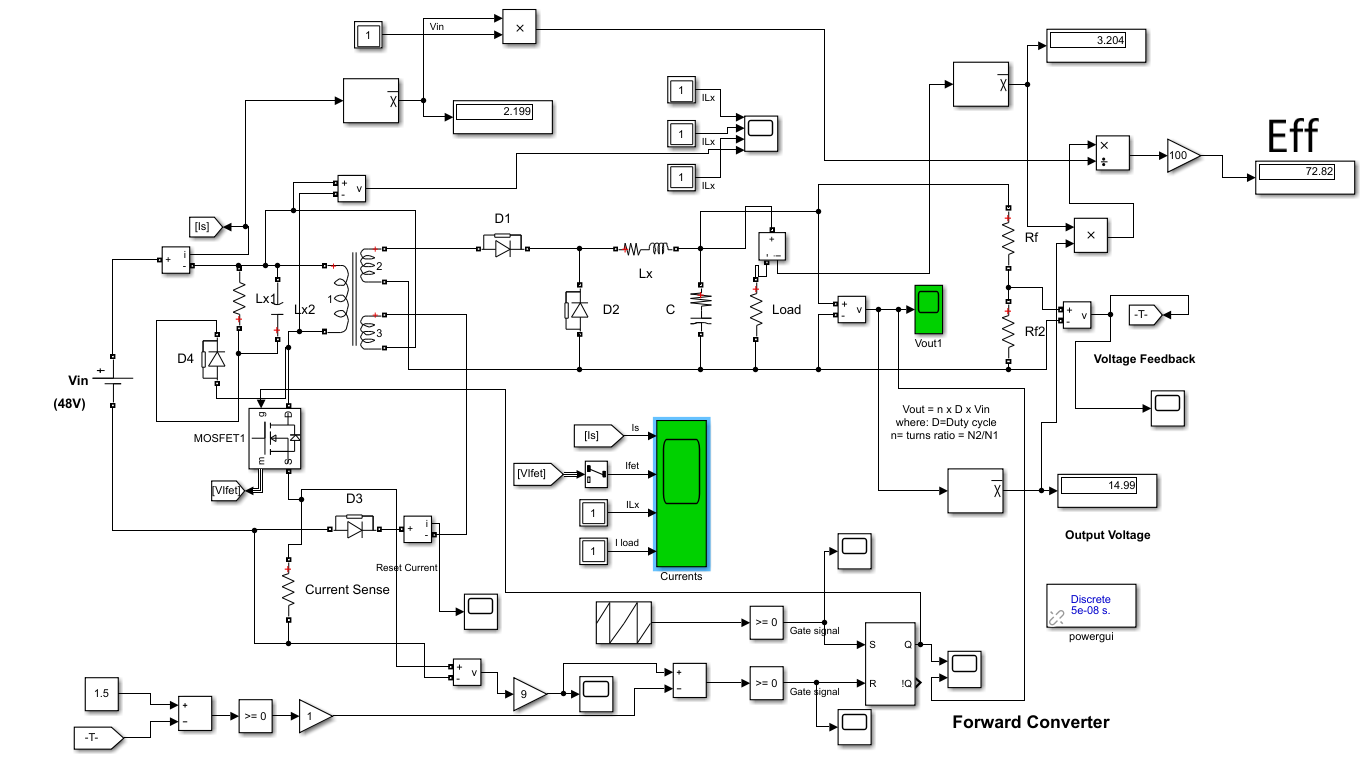
final_report/Sumilation.png
