burakkemalkara/MetuInstrumentProject/final_report/tcase.png

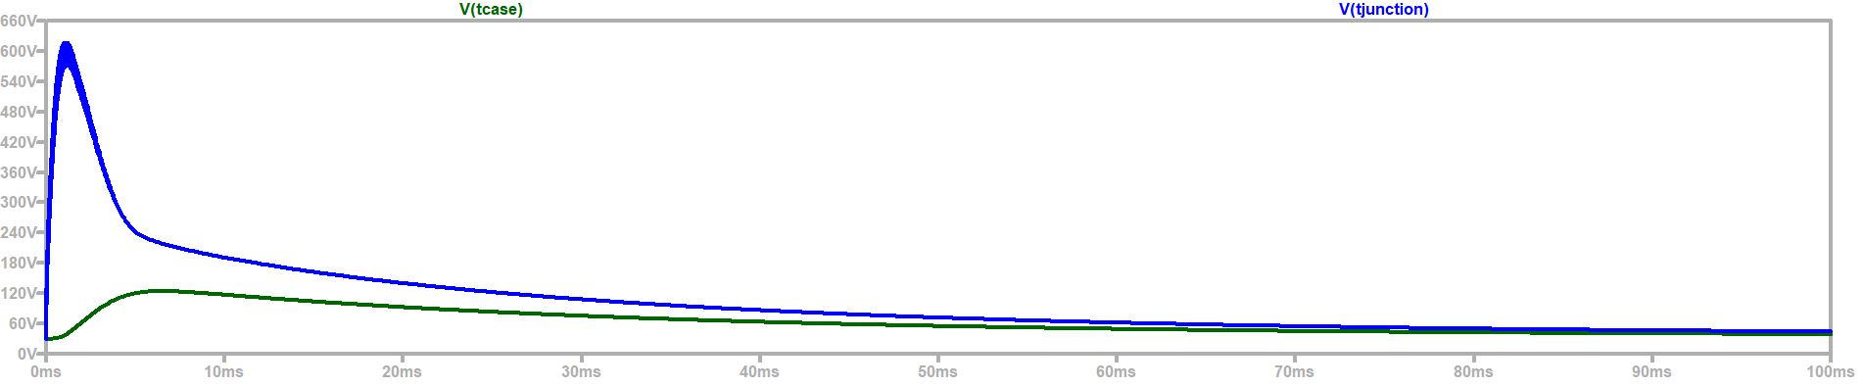
final_report/tcase.png
