burakkemalkara/MetuInstrumentProject/PCB/forward_converter_opto.png

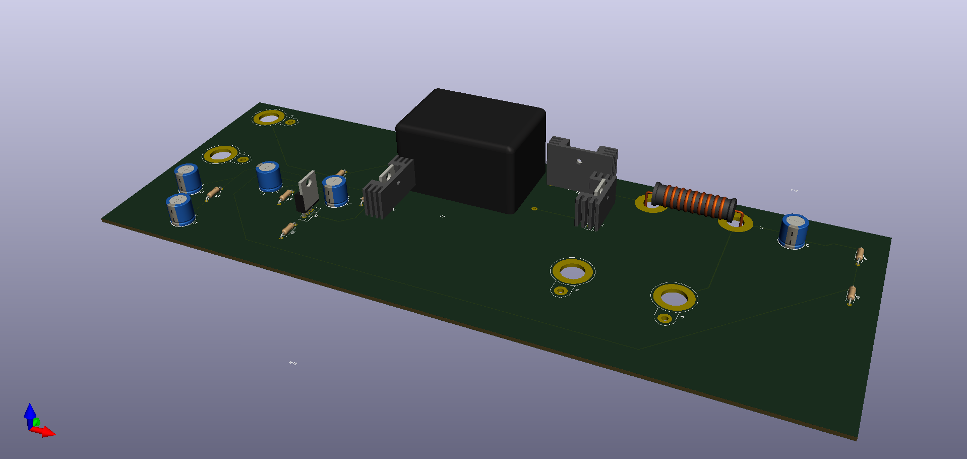
PCB/forward_converter_opto.png
