burakkemalkara/MetuInstrumentProject/PCB/PCB 3D Images/bottom.PNG

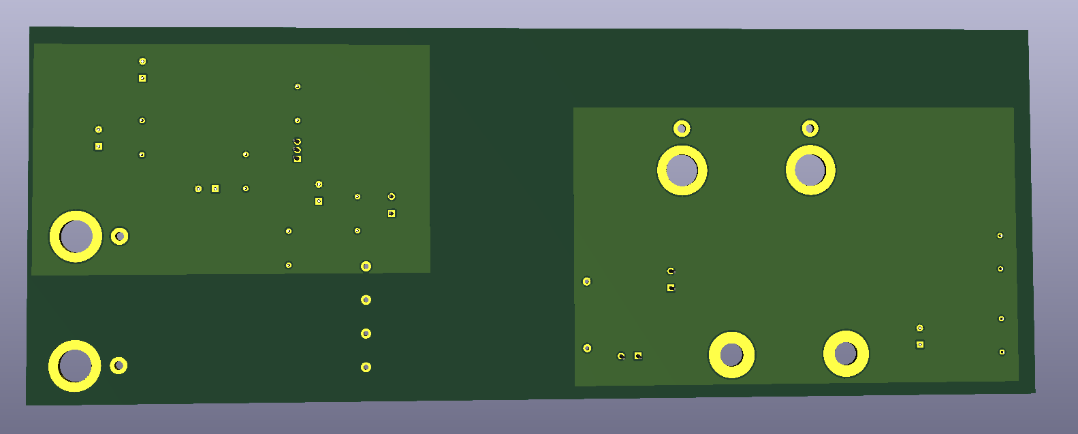
PCB/PCB 3D Images/bottom.PNG
