burakkemalkara/MetuInstrumentProject/PCB/PCB 3D Images/Top wiev.PNG

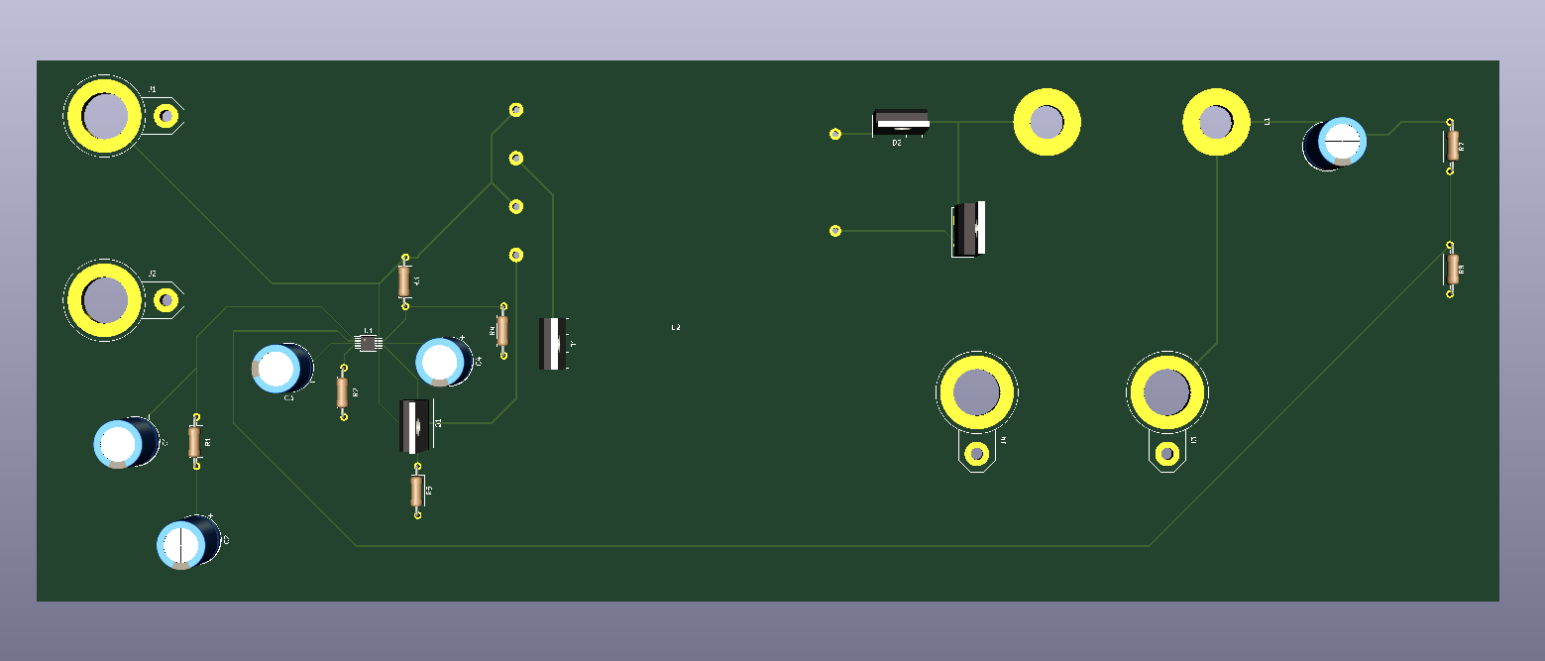
PCB/PCB 3D Images/Top wiev.PNG
