burakkemalkara/MetuInstrumentProject/PCB/PCB 3D Images/çarpaz.PNG

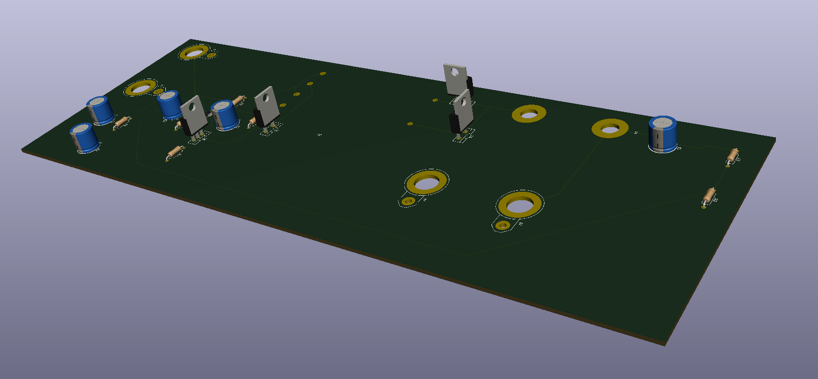
PCB/PCB 3D Images/çarpaz.PNG
