burakkemalkara/MetuInstrumentProject/VC.PNG

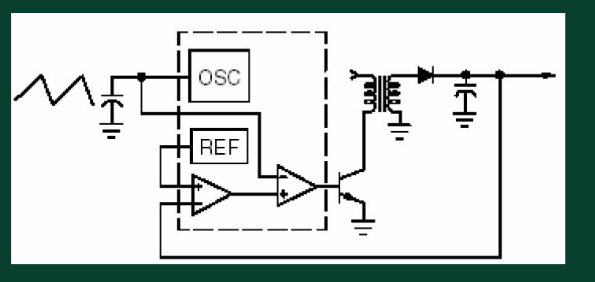
VC.PNG
