burakkemalkara/MetuInstrumentProject/BOM.xlsx

Reference | Quantity | Value | Footprint | Datasheet | Unit Price ($) | Total Price ($)
C1 | 1 | 100p | Capacitor_THT:CP_Radial_D10.0mm_P5.00mm | ~ | 0.04 | 0.04
C2 | 1 | 10n | Capacitor_THT:CP_Radial_D10.0mm_P5.00mm | ~ | 0.04 | 0.04
C3 | 1 | 0.1u | Capacitor_THT:CP_Radial_D10.0mm_P5.00mm | ~ | 0.04 | 0.04
C4 | 1 | 4.7u | Capacitor_THT:CP_Radial_D10.0mm_P5.00mm | ~ | 0.04 | 0.04
C5 | 1 | 100u | Capacitor_THT:CP_Radial_D10.0mm_P5.00mm | ~ | 0.45 | 0.45
D1 D2 D3 | 3 | D | Package_TO_SOT_THT:TO-220-2_Vertical | ~ | 1.07 | 3.21
J1 J2 J3 J4 | 4 | Conn_Coaxial | Connector_Coaxial:BNC_PanelMountable_Vertical | ~ | 0.2 | 0.8
L1 | 1 | 470u | forward_converter:fw_inductor | ~ | 12.4 | 12.4
Q1 | 1 | IRFB4127PBF | Package_TO_SOT_THT:TO-220-3_Vertical | http://www.vishay.com/docs/91054/91054.pdf | 2.98 | 2.98
R1 | 1 | 16.2k | Resistor_THT:R_Axial_DIN0207_L6.3mm_D2.5mm_P10.16mm_Horizontal | ~ | 0.01 | 0.01
R2 | 1 | 49.9k | Resistor_THT:R_Axial_DIN0207_L6.3mm_D2.5mm_P10.16mm_Horizontal | ~ | 0.01 | 0.01
R3 | 1 | 200k | Resistor_THT:R_Axial_DIN0207_L6.3mm_D2.5mm_P10.16mm_Horizontal | ~ | 0.01 | 0.01
R4 | 1 | 32.4k | Resistor_THT:R_Axial_DIN0207_L6.3mm_D2.5mm_P10.16mm_Horizontal | ~ | 0.01 | 0.01
R5 | 1 | 0.01 | Resistor_THT:R_Axial_DIN0207_L6.3mm_D2.5mm_P10.16mm_Horizontal | ~ | 0.01 | 0.01
R7 | 1 | 83.75k | Resistor_THT:R_Axial_DIN0207_L6.3mm_D2.5mm_P10.16mm_Horizontal | ~ | 0.01 | 0.01
R8 | 1 | 10k | Resistor_THT:R_Axial_DIN0207_L6.3mm_D2.5mm_P10.16mm_Horizontal | ~ | 0.01 | 0.01
U1 | 1 | LT3758 | Package_SO:MSOP-10_3x3mm_P0.5mm |  | 5.92 | 5.92
U2 | 1 | designed_transformer_model | forward_converter:forward_converter_transformer |  | 10 | 10
Total Price($) |  |  |  |  |  | 35.99
