burakkemalkara/MetuInstrumentProject/Simulation/LTspice/Forward Converter Compensated.asc

C1: cap; 100µ; Rser=0.05
C2: cap; 2n
C3: cap; 0.26n
C4: cap; 22n
D1: diode
D2: diode
D3: diode
L1: ind2; 300µ; Rser=0.05
L2: ind2; 1875µ; Rser=0.06
L3: ind2; 470µ; Rser=11.5m
L4: ind2; 300µ; Rser=0.05
Q1: nmos; BSC320N20NS3
R1: res; 4.68
R2: res; 10.77k
R3: res; 1k
R4: res; 130
R5: res; 1.5k
R6: res; 900k
R7: res; 450k
U1: UniversalOpamp2
U2: UniversalOpamp2
U3: UniversalOpamp2
V1: voltage; 30
V2: voltage; 15
V3: voltage; -15
V4: voltage; 3
V5: voltage; 1
V6: voltage; 15
V7: voltage; PULSE(0 3 0 5u 5u 0 10u)
Named nets: 0
K1 L1 L2 L4 1
.tran 0.1
