burakkemalkara/MetuInstrumentProject/Simulation/LTspice/Forward Converter.asc

C1: cap; 100µ; Rser=0.05
C2: cap; 10n
C3: cap; 100p
C4: cap; 0.1µ
C5: cap; 4.7µ
D1: diode
D2: diode
D3: diode
L1: ind2; 300µ; Rser=0.05
L2: ind2; 1875µ; Rser=0.06
L3: ind2; 470µ; Rser=11.5m
L4: ind2; 300µ; Rser=0.05
Q1: nmos; BSC320N20NS3
R1: res; 0.01
R2: res; 4.68
R3: res; 16.2k
R4: res; 140k
R5: res; 83.75k
R6: res; 10k
R7: res; 200k
R8: res; 32.4k
U1: LT3758A
V1: voltage; 30
Named nets: 0
K1 L1 L2 L4 1
.tran 2
