burakkemalkara/MetuInstrumentProject/Simulation/LTspice/transformer.asc

L1: ind; 14.955m
L2: ind; 341.085m
L3: ind; 341.085m
R1: res; 62.658m
R2: res; 1543342
R3: res; 491.993m
R4: res; 1543342
R5: res; 491.993m
R6: res; 5
R7: res; 5
U1: Core; Hc=5.7 Bs=1866m Br=1664m; A=0.7559 Lm=6.738 Lg=0
U2: Winding_RC; N=112
U3: Winding_RC; N=902
U7: Winding_RC; N=112
U8: Winding_RC; N=902
U9: Core; Hc=5.7 Bs=1897.508m Br=1664m; A=0.7559 Lm=6.738 Lg=0
V1: voltage; PULSE(0 10 0 0 0 0.015 0.02)
Named nets: 0
.tran 0 300 0 5u
; Power Factor Calculation:
.meas start PARAM 299960ms
.meas end PARAM 300000ms
.meas Irms RMS Ix(U2:1) from start to end
