burakkemalkara/MetuInstrumentProject/PCB/forward_converter_opto.kicad_pcb

## KiCad design PCB/forward_converter_opto.kicad_pcb (2020-06-24)

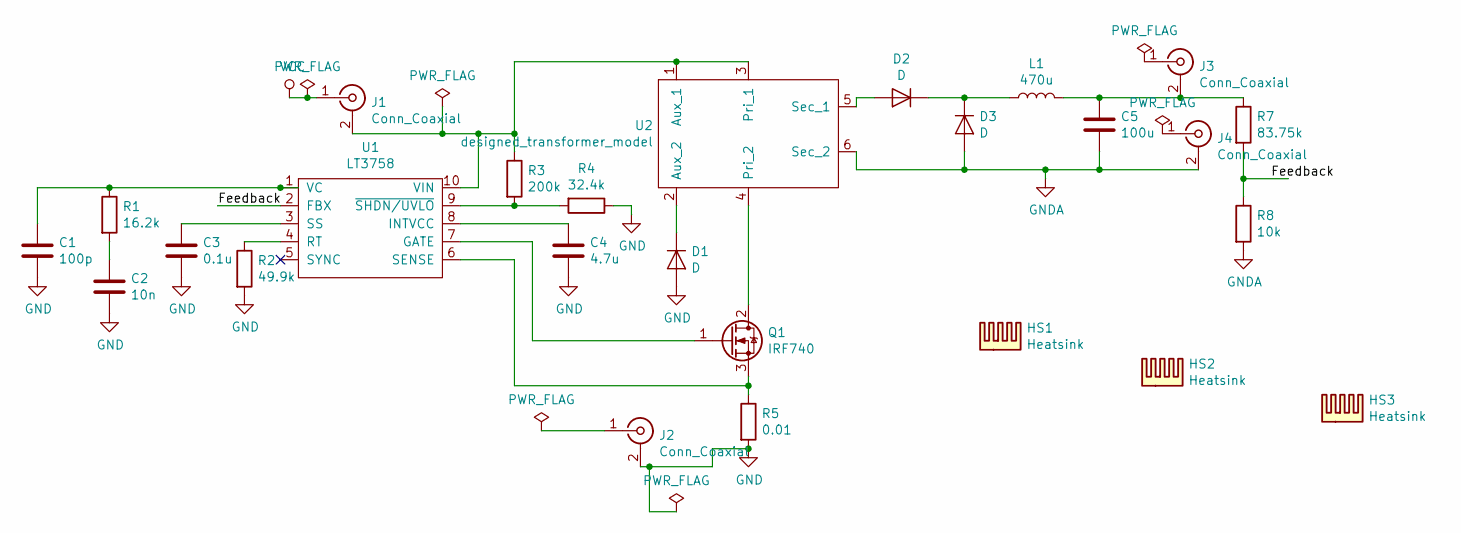
[picture p52: schematic forward_converter_opto.sch]

Parts:
C1: 100p; CP_Radial_D10.0mm_P5.00mm
C2: 10n; CP_Radial_D10.0mm_P5.00mm
C3: 0.1u; CP_Radial_D10.0mm_P5.00mm
C4: 4.7u; CP_Radial_D10.0mm_P5.00mm
C5: 100u; CP_Radial_D10.0mm_P5.00mm
D1, D2, D3: D; TO-220-2_Vertical
HS1, HS2, HS3: Heatsink; heatsink
J1, J2, J3, J4: Conn_Coaxial; BNC_PanelMountable_Vertical
L1: 470u; fw_inductor
Q1: IRF740; TO-220-3_Vertical
R1: 16.2k; R_Axial_DIN0207_L6.3mm_D2.5mm_P10.16mm_Horizontal
R2: 49.9k; R_Axial_DIN0207_L6.3mm_D2.5mm_P10.16mm_Horizontal
R3: 200k; R_Axial_DIN0207_L6.3mm_D2.5mm_P10.16mm_Horizontal
R4: 32.4k; R_Axial_DIN0207_L6.3mm_D2.5mm_P10.16mm_Horizontal
R5: 0.01; R_Axial_DIN0207_L6.3mm_D2.5mm_P10.16mm_Horizontal
R7: 83.75k; R_Axial_DIN0207_L6.3mm_D2.5mm_P10.16mm_Horizontal
R8: 10k; R_Axial_DIN0207_L6.3mm_D2.5mm_P10.16mm_Horizontal
U1: LT3758; MSOP-10_3x3mm_P0.5mm
U2: designed_transformer_model; forward_converter_transformer

Connections:
/Feedback: R7.2, R8.1, U1.2 (FBX)
GND: C1.2, C2.2, C3.2, C4.2, D1.2 (A), J2.2 (Ext), R2.2, R4.1, R5.2
GNDA: C5.2, D3.2 (A), J4.2 (Ext), R8.2, U2.6 (Sec_2)
unnamed: C1.1, R1.1, U1.1 (VC)
unnamed: C2.1, R1.2
unnamed: C3.1, U1.3 (SS)
unnamed: C4.1, U1.8 (INTVCC)
unnamed: C5.1, J3.2 (Ext), L1.2, R7.1
unnamed: D1.1 (K), U2.2 (Aux_2)
unnamed: D2.1 (K), D3.1 (K), L1.1
unnamed: D2.2 (A), U2.5 (Sec_1)
unnamed: J1.2 (Ext), R3.1, U1.10 (VIN), U2.1 (Aux_1), U2.3 (Pri_1)
unnamed: Q1.1 (G), U1.7 (GATE)
unnamed: Q1.2 (D), U2.4 (Pri_2)
unnamed: Q1.3 (S), R5.1, U1.6 (SENSE)
unnamed: R2.1, U1.4 (RT)
unnamed: R3.2, R4.2, U1.9 (~SHDN/UVLO)
VCC: J1.1 (In)

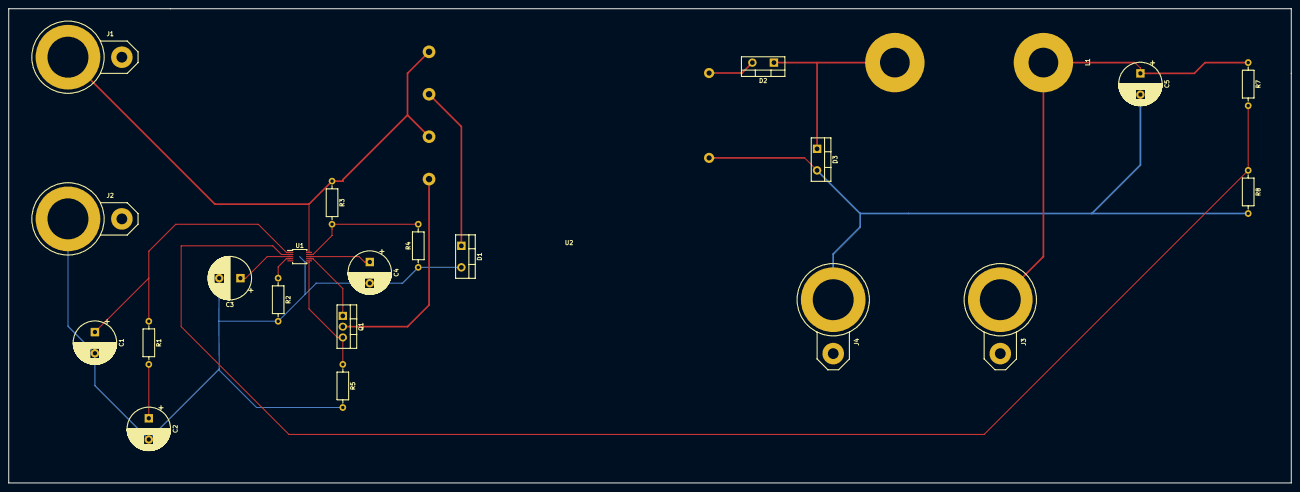
[picture p53: board forward_converter_opto.kicad_pcb from above]

Board: 2 copper layers, 302.3 x 111.8 mm, 26 parts (0 on the bottom side), 17 nets.
