burakkemalkara/MetuInstrumentProject/(commit log)

2020-03-23 Mosfet Consideration
2020-03-23 Power clacultions are done, few things to complete
2020-06-23 Add files via upload
    PCB schematic, and footprints completed
    [forward_converter.kicad_pcb, forward_converter.sch, forward_converter_opto.kicad_pcb, forward_converter_opto.sch]
2020-06-24 Controller calculations completed and new mosfet selected
    [forward_converter.sch]
2020-06-24 Add files via upload
    PCB design is completed except thickness and width adjustments of connections
    [forward_converter.sch, forward_converter_opto.sch]
2020-06-24 Add files via upload
    PCB design is completed, ground plane added, width of layers adjusted,
    3D images of designed PCB is added
    [forward_converter_opto.kicad_pcb]
2020-06-24 Add files via upload
    Gerber Files and BOM added
    Final Design of our PCB
    Note that forward_converter_opto files are designed PCB
    [BOM.xlsx]
2020-06-24 Add files via upload
    Bill of Materials (BOM)
    [BOM.xlsx]
2020-06-24 Project completely finished
    [forward_converter.kicad_pcb, forward_converter.sch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]
2020-06-24 Report changed
    [forward_converter_opto.csv]
